jvitkauskas/m-card/docs/template-1to1.pdf

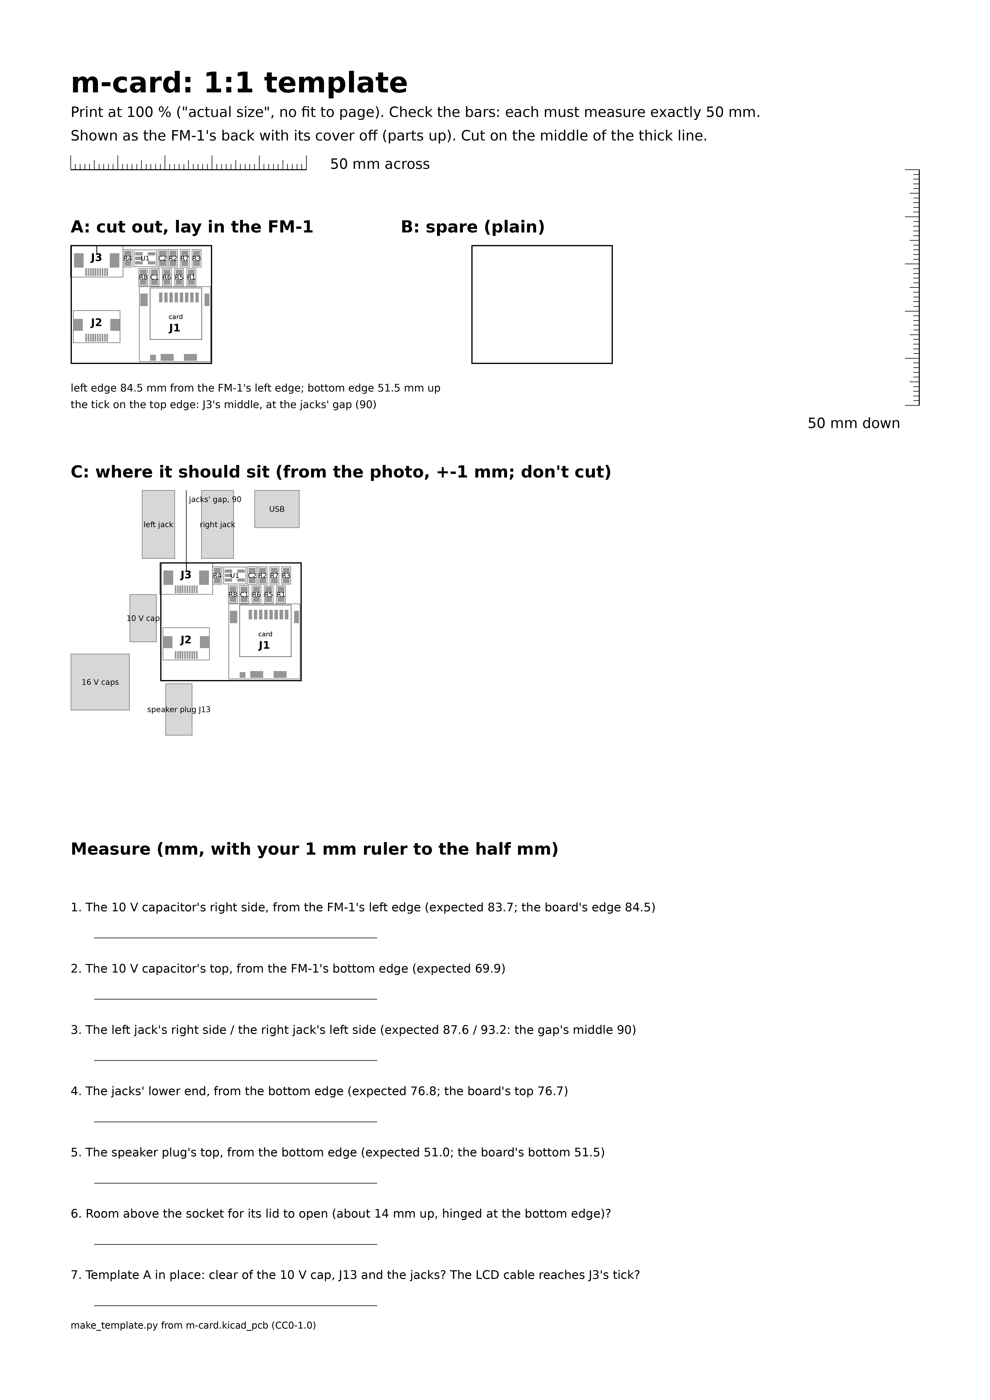
[picture p3: page 1]
