jvitkauskas/m-card/fab/bom.csv

Comment | Designator | Footprint | LCSC Part #
10uF | C1 | C_0805_2012Metric_Pad1.18x1.45mm_HandSolder | C15850
100nF | C2 | C_0805_2012Metric_Pad1.18x1.45mm_HandSolder | C49678
microSD hinged (Hirose DM3CS-SF) | J1 | microSD_Hirose_DM3CS-SF_hinged | C202111
FPC 10P 0.5 bottom contact | J2 | FPC_10P_0.5_XUNPU_FPC-05F-10PH20 | C2856798
FPC 10P 0.5 top contact | J3 | FPC_10P_0.5_XUNPU_FPC-0.5AS-10PWBH20 | C3446068
220 | R1 | R_0805_2012Metric_Pad1.20x1.40mm_HandSolder | C17557
470 | R5,R6 | R_0805_2012Metric_Pad1.20x1.40mm_HandSolder | C17710
47k | R2,R3,R4,R7,R8 | R_0805_2012Metric_Pad1.20x1.40mm_HandSolder | C17713
74LVC1G04 | U1 | SOT-23-5_HandSoldering | C7827
