jvitkauskas/m-card/docs/assembly.pdf

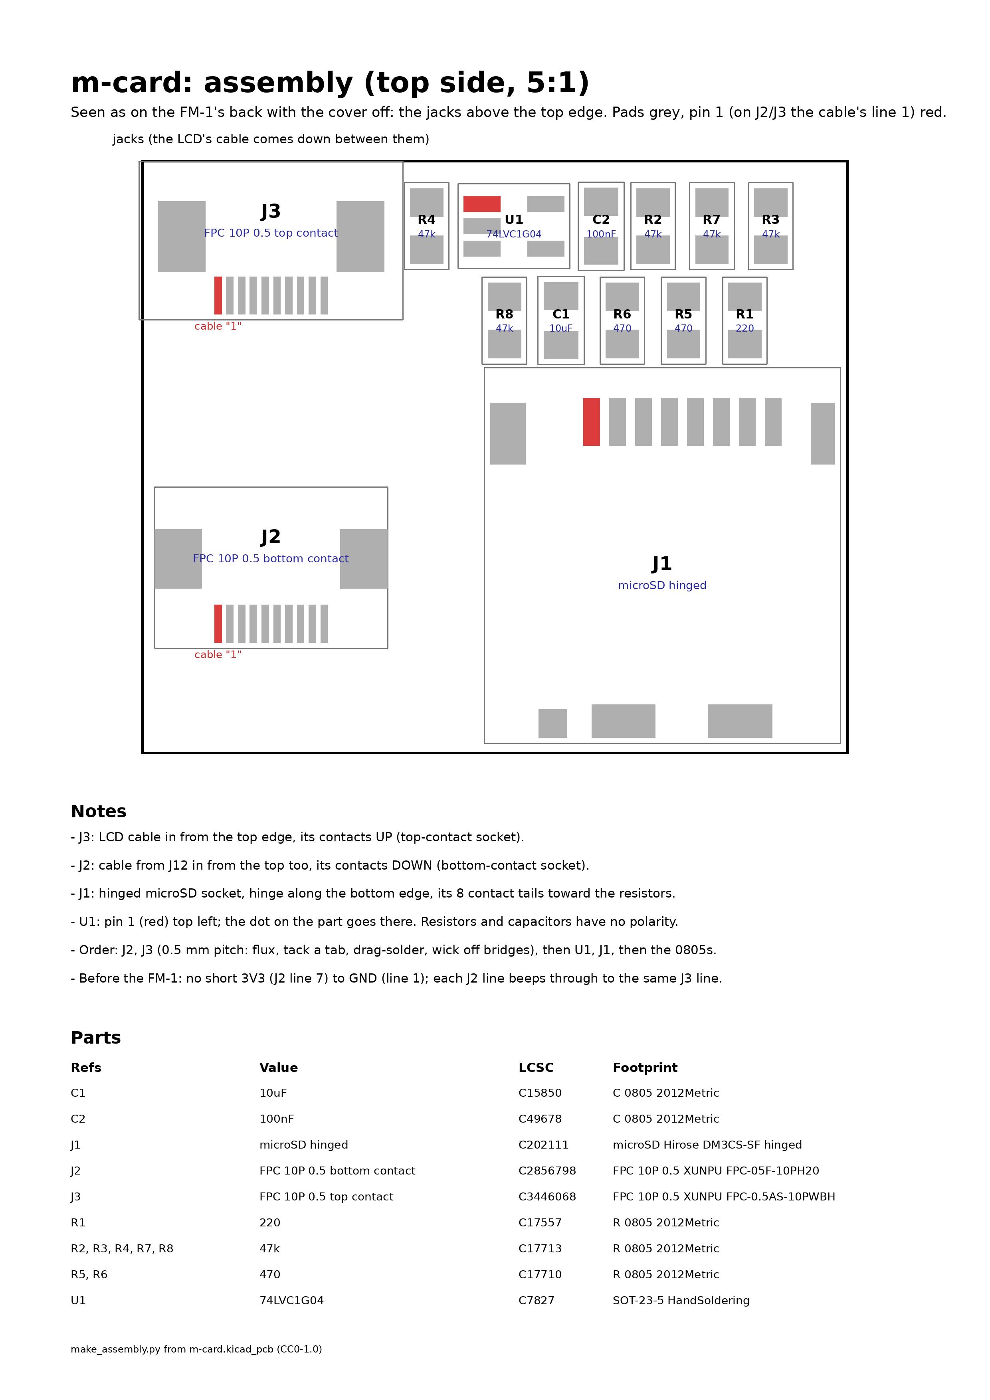
[picture p5: page 1]
