jvitkauskas/m-card/m-card.kicad_pcb

## KiCad design m-card.kicad_pcb (2026-11-03)

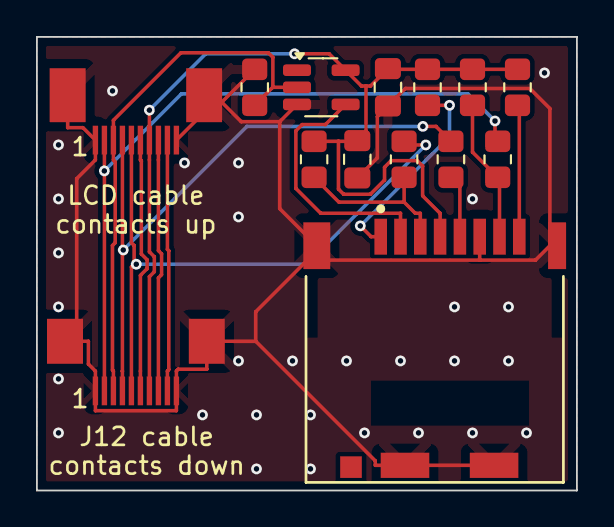
[picture p4: board m-card.kicad_pcb from above]

Board: 2 copper layers, 30.0 x 25.2 mm, 14 parts (0 on the bottom side), 15 nets.

Parts:
C1: 10uF; C_0805_2012Metric_Pad1.18x1.45mm_HandSolder
C2: 100nF; C_0805_2012Metric_Pad1.18x1.45mm_HandSolder
J1: microSD hinged (Hirose DM3CS-SF); microSD_Hirose_DM3CS-SF_hinged
J2: FPC 10P 0.5 bottom contact; FPC_10P_0.5_XUNPU_FPC-05F-10PH20
J3: FPC 10P 0.5 top contact; FPC_10P_0.5_XUNPU_FPC-0.5AS-10PWBH20
R1: 220; R_0805_2012Metric_Pad1.20x1.40mm_HandSolder
R2, R3, R4, R7, R8: 47k; R_0805_2012Metric_Pad1.20x1.40mm_HandSolder
R5, R6: 470; R_0805_2012Metric_Pad1.20x1.40mm_HandSolder
U1: 74LVC1G04; SOT-23-5_HandSoldering

Connections:
3V3: C1.1, C2.1, J1.4, J2.4, J3.4, R2.1, R3.1, R7.1, R8.1, U1.5
CARD_CS: J1.2, U1.4
CLK: J2.7, J3.7, R5.1
DAT0: J1.7, R1.2, R7.2
DAT1: J1.8, R3.2
DAT2: J1.1, R2.2
GND: C1.2, C2.2, J1.6, J1.9, J2.1, J2.10, J2.11, J2.12, J3.1, J3.10, J3.11, J3.12, R4.2, U1.3
LCD_6: J2.5, J3.5
LCD_8: J2.3, J3.3
LCD_9: J2.2, J3.2
LCD_CS: J2.8, J3.8, R4.1, U1.2
MISO: J2.9, J3.9, R1.1
MOSI: J2.6, J3.6, R6.1
SD_CLK: J1.5, R5.2
SD_DI: J1.3, R6.2, R8.2
