jvitkauskas/m-card/(notices)

Notices in the files:
m-card.kicad_pcb:
for FM-1 CC0-1.0
